dayaftereh/open-knx-valve-control/docs/KNX094_M1_R_10S_LIVE_20261020.md

# KNX094 – Live-Test M1, 10 Sekunden Rueckwaertsfahrt

Stand: 20.10.2026, LLO Desktop Agent v0.8.2.
Board: OpenKNXValveControl V1.2.

## Ergebnis

Der Nutzer beauftragte einen einzelnen 10-Sekunden-Langzeittest
mit Stromueberwachung, um eine vermutete Hard-Endlage des Ventilmotors
im Pruefstand zu beobachten. Gewaehlt wurde die vorher getestete
Richtung R. **Der Impuls lief bis zum 10-Sekunden-Zeitlimit.
Kein Stromanstieg einer mechanischen Blockierung wurde erkannt.**

Aufbau laut Nutzer: USB-C RP2040, Motor M1, sonst keine KNX-,
UPDI- oder Temperatursensorverbindungen. USB Live-ID: COM7,
VID:PID 2E8A:000A, Seriennummer E464401787522D33.
INA219 0x40, Konfiguration 0x399F. R29 0,200 Ohm/1 W.
R33/R34 wurden zuvor auf jeweils 10 Ohm repariert;
INA219-Leerlauf auf plausiblen ca. 0-1mA.

## KNX094 Firmware (aktuell auf dem Board)

Eine separate reproduzierbare Ableitung der zuletzt verifizierten
KNX093-Testfirmware. Die neue Firmware wurde per PlatformIO Core
6.1.16 erfolgreich gebaut: RAM 23,1%, Flash 5,2%.
UF2 **243712 Byte**, SHA256
**c59596c3e3ba27fdd30adc094219953d47a7c59185ce2f55e00b1d04a2d5e284**.

- Es wird nur M1 Rueckwaerts, exakt 10000 ms, angenommen.
  Andere Kanaele, Richtungen und Zeiten werden abgewiesen.
- Keine Motorbewegung beim Boot, KNX TX stets LOW.
- Der Motor braucht ein 5-Sekunden-USB-ARM-Freigabefenster.
- Hardwarezeitgrenze in Firmware: 10000 ms.
- INA219: ca. alle 8 ms beim Motorlauf, bis 1500 Rohtracepunkte.
- Abbruch bei I2C-Fehler, Versorgung ausser 3,10–3,45 V,
  Laufstrom ueber 120 mA oder USB-Verlust.
- Zusaetzlicher Blockierverdacht: erst ab t=400ms, bei
  mindestens 60 mA in 6 direkt aufeinanderfolgenden validen
  INA-Proben wird ein verriegelter FAULT ausgeloest.
  Das ist eine **Software-Strompruefung, keine
  unabhaengige Hardware-Sicherheitsabschaltung**.
- Live-Strommeldungen ca. alle 200 ms.
- Nach Motorende redundanter STOP, STATUS, INA und TRACE.
- Einmalige Flash-/Motor-Marker in Runtime verhindern
  automatische erneute Ausloesung.

Firmwarequelle und Generator:
tools/knx094_motor_10s/src/main.cpp
tools/knx094_motor_10s/src/motor_gate.hpp
tools/knx094_motor_10s/platformio.ini
tools/knx094_motor_10s/generate_from_knx093.py
Host:
tools/knx094_motor_10s/knx094_host.py
tools/knx094_motor_10s/generate_host.py
Offline-Regression: tools/test_knx094_motor_10s.py,
**6/6 PASS**; Python Syntax PASS.

## Flash-Vorgang

Preflight verifizierte COM7, exakte Board-Seriennummer,
Motoren LOW und INA219 Ruhewerte 0..1mA, Bus 3,288–3,292V.
RP2040 per USB CDC1200 in ROM versetzt, Boot-ROM-Flash-ID
E464401787522D33 verifiziert; gepinntes UF2 einmalig
ueber picotool mit Verify und Start geflasht.

Besonderheit: Im KNX094-Build war der alte passive
Diagnosebefehl KNX093 zur Versionsabfrage noch erhalten;
er antwortet aber mit der eindeutigen KNX094-Signatur.
Der erste automatische Post-Flash-Check hatte wegen der
Anfrage KNX094 statt KNX093 abgebrochen. Ein direkter,
rein lesender USB-Check bestaetigte neue KNX094-Firmware,
IDLE und alle GPIOs LOW. Der Host wurde korrigiert und
vollstaendig verifiziert. **Kein zweiter Flash**.

Firmware-Version ueber Diagnosebefehl KNX093:
KNX094 M1_R_ONLY duration_ms=10000 motor_gate=1
limit_ma=120 stall_ma=60 after_ms=400 consecutive=6 latched=0

## Echte einmalige 10s-Fahrt

USB-Befehl: ARM MOTORS, danach PULSE M1 R 10000.
PULSE_STARTED und MOTOR_ENDED state=IDLE bestaetigt.
50 LIVE-Meldungen (200..10000ms), 1250/1250 gueltige
INA219-Rohsamples mit 8-ms-Abstand, t=7..9999ms.

| Kennzahl | Live-Ergebnis |
| --- | ---: |
| Angeforderter Zeitraum | 10000 ms |
| Gueltige INA219-Rohwerte | 1250/1250 |
| Zeitfenster | 7 bis 9999 ms |
| Max. erfasster Anlaufstrom (t=7 ms) | 112,05 mA |
| Min. Strom | 22,85 mA |
| Median gesamt | 28,0 mA |
| Median ab t=400ms | 27,825 mA |
| Maximalwert ab t=400ms | 34,5 mA |
| Strom bei t=9999ms | 31,55 mA |
| Motorversorgung M_VCC | 3260–3288 mV |
| Werte >=60mA nach t400ms | 0 |
| Strom-/Blockier-FAULT | Nein |
| Firmware-Endzustand | IDLE |
| STOP ACK und Ausgangspins LOW | Ja |
| Leerlaufstrom nach STOP | nominal 0 mA |

Der hohe Anlaufwert faellt in den ersten Millisekunden
ab. Ab etwa 400ms bleibt der Strom praktisch konstant
zwischen 23 und 35mA, auch bis zum Ende der 10 Sekunden.
**Ein Hard-End-Anschlag wurde elektrisch NICHT beobachtet.**

Das bedeutet NICHT, dass die Welle nachweislich stillstand:
Moeglich sind ein weiter frei laufender Antrieb, ein
groesserer Weg als 10s oder eine fehlende Getriebe-/
Ventilkopplung. Ob der Nutzer den Motor gehoert/gesehen hat,
wurde noch nicht bestaetigt. Ein kurzer Einschaltpeak
vor dem ersten Messpunkt t7ms wurde nicht erfasst.

## Echtmessdaten und Folgeschritte

Nur auf LLO Desktop unter:
C:\ASH\Workspace\Runtime\KNX094

Dateien:
- KNX094_FLASH_20261020_092752.json
- KNX094_M1_R10000_20261020_093009.json
- KNX094_M1_R10000_20261020_093009.csv
- KNX094_FLASH_STARTED.flag
- KNX094_M1_R10000_STARTED.flag

Die beiden Marker und Messdateien nicht entfernen, um
automatisch noch einmal zu fahren. Kein zweiter Motorpuls
wurde ausgefuehrt. M1 bleibt ausgeschaltet.

Naechster Schritt: Nutzer fragen, ob M1 bei 10 Sekunden
tatsaechlich drehte bzw. mechanische Bewegung/Anschlag
sichtbar oder hoerbar war. Ohne Endstop-Signatur vor
weiteren Laufzeiterhoehungen Kupplung, Getriebe,
Ventilweg und Verschaltung pruefen. Kein Git Push
ohne separate Freigabe.
