dayaftereh/open-knx-valve-control/docs/KNX090_INA219_CLEANED_R33_R34_MPN_20K_20261019.md

# KNX090 – INA219 nach Reinigung; 20 kOhm Sense-Pfad

Stand: 19.10.2026, ca. 22:18 MESZ, LLO Home Agent v0.7.9.

## Benutzer-Messungen nach Platinenreinigung

- Dreck/Flussmittel-/Lotrueckstaende zwischen U23/INA-Pads wurden entfernt.
- Spannung an den U23-seitigen Sense-Pads von R33 Pad2 (IN+) nach
  R34 Pad2 (IN-): ca. **+82 mV** laut Nutzer.
- Ohmischer Messwert zwischen R33 Pad2 und R34 Pad2 laut Nutzer:
  ca. **20 kOhm**.
- Zuvor direkt an R29 (200 mOhm/1 W) ca. **0.00 mV DC** laut Nutzer.
- Bei der Ohm-Messung wurde der Versorgungszustand nicht
  mitgeteilt. Ohm-Werte sind nur bei VOLLER Spannungsfreiheit
  interpretierbar. USB, KNX und UPDI koennen mehrere
  Versorgungsquellen darstellen.

## Live-RP2040 nach der Reinigung

Keine Motorbewegung, kein Reset/Flash, nur KNX089 INA_REGS:
- RP2040 COM8, bekanntes USB-Gerät.
- CONFIG 0x00 = **0x399F**.
- SHUNT 0x01 = **9259 LSB = 92.59 mV**.
- VBUS 0x02 = **3148 mV**.
- CAL 0x05 = **0** (erwartbar; Roh-Shunt ohne CAL nutzbar).
- Motorausgaenge KNX089 firmwareseitig LOCKED, gate0, GPIO LOW.

Beleg:
C:\_myspace\workspace\Builds\OpenKNXValveControl\KNX089_R29_0MV\KNX089_REGISTER_DIAG_20261019_221814.json

Der Wert hat sich durch die Reinigung (zuvor ~92.6mV) nicht
erkennbar geaendert. User-DMM 82mV und INA 92.59mV sind in derselben
Groessenordnung, aber keinesfalls gleich und kein Beweis
einer korrekt angeschlossenen Sensoreingangsstrecke.

## Unerwarteter EDA/MPN-Widerspruch bei R33/R34

Quellstand: schematic/pcb_knx-valve-control_v1.2.json

| Teil | Symbolischer WERT | Pad1 PCB | Pad2 PCB | MPN/LCSC |
|---|---|---|---|---|
| R33 | 10 Ohm | 3.3V | U23_8, INA219 IN+ | 0402WGF1002TCE / C25744 |
| R34 | 10 Ohm | M_VCC | U23_7, INA219 IN- | 0402WGF1002TCE / C25744 |
| R29 | 0.200 Ohm,1W user confirmed | 3.3V | M_VCC | PCB MPN not trustworthy |

Hersteller-/Lieferanten-Katalog fuer **C25744 / 0402WGF1002TCE**:
UNI-ROYAL **10kOhm ±1%**, Gehaeuse **0402**.
Beleg: https://www.lcsc.com/de/product-detail/C25744.html

Ein tatsaechlich eingebautes Widerstandspaar R33+R34
mit 10kOhm ergibt zusammen ueber R29 ca.
**10,000 + 0.200 + 10,000 = 20,000.2 Ohm**.
Dies stimmt bemerkenswert gut mit den 20kOhm des Nutzers ueberein.
Bei den im Schaltplansoll enthaltenen 10Ohm je Widerstand
waeren nur ca. **20.2 Ohm** zu erwarten, solange die
Sense-Leitungen zwischen R33/R34 und R29 durchgaengig sind.

**WICHTIG**: Das EasyEDA-Projekt benutzt dieselbe 10kOhm
Bauteilnummer nicht nur bei R33/R34, sondern bei 37
Widerstands-Footprints mit voellig verschiedenen
Design-Werten. Ebenso ist die MPN CC0603KRX7R9BB103
(10nF, C100042) bei 24 Kondensatoren mit gemischten
Design-Werten hinterlegt, darunter C31 (100nF SOLL).
Die MPNs sind daher anscheinend pauschale Bibliotheks-
Metadaten und **KEIN verlaesslicher Bestueckungsnachweis**.
Ob R33 und R34 real 10kOhm enthalten, beweist nur eine
geeignete individuelle stromlose Widerstandsmessung bzw.
Bestueckungsnachweis.

Starkes Verdachtsmoment: R33/R34 physisch als 10kOhm statt
10Ohm bestueckt (oder ein offener Sense-Pfad). Solche
hochohmigen Sense-Zuleitungen koennen zusammen mit INA219-
Eingangsbias/Leckstroemen und Flussmittelresten falsche
Differenzwerte im ADC verursachen. Das rein digitale I2C-
Register-Reading bleibt dabei fehlerfrei.

## Naechster Test vor weiterer INA219-Firmwarearbeit

Bei **komplett stromloser Platine** (USB, KNX-TP-Stecker,
UPDI ab, Puffer entladen) R33 und R34 **einzeln
zwischen jeweils Pad1 und Pad2** im Ohm-Modus messen.

- R33 etwa 10kOhm und R34 etwa 10kOhm:
  Widerstands-Bestueckung ist sehr wahrscheinlich FALSCH;
  je 10Ohm 0402 einsetzen und Sense-Differenz unter
  sicherer Versorgung neu pruefen.
- Beide je ~10Ohm:
  dann Unterbrechung von den Serien-R zu R29
  oder echte Leiterbahn-/Kontaktprobleme genauer pruefen.
- Nur einer ~10kOhm / offen:
  genau diese Verbindung bzw. Bestueckung lokalisieren.

Keine Ohm-Messung bei angeschlossener Spannung.
Falls Messwerte in-circuit uneindeutig, ein Anschluss
stromlos entloeten oder mit Originalbestueckungsunterlagen
vergleichen; nicht aus bloßer MPN schließen.

Motoren und KNX TX bleiben bei aktueller KNX089-Firmware
gesperrt. Kein neuer Flash, keine Motorfahrt, kein Git Push.

Empfehlung fuer kommende PCB-Version: BOM/MPN fuer R33,
R34 und weitere Bauteile konsistent mit Designwerten
ueberarbeiten; pauschale Platzhalter entfernen.
