dayaftereh/open-knx-valve-control/docs/KNX086_R17_LIVE_FLASH_INA219_20261019.md

# NACHFOLGENDER KNX087-BESTUECKUNGSNACHTRAG / 19.10.2026

Der Nutzer hat R29 als tatsaechlich bestueckten **200-mOhm-/1-W-Shunt** bestaetigt. Die fruehere Ungewissheit ueber die R29-Bestueckung und die Aufforderung, diesen Sollwert nochmals durch die BOM zu bestaetigen, ist damit ueberholt. Der Code rechnet bereits mit 200 mOhm, sodass keine Neukonfiguration/kein Firmwareflash erforderlich ist. Die gemessenen ~463 mA im Stillstand bei ausgeloeschten Motorausgaengen bleiben jedoch eine ungeklare M_VCC-Ruhebelastung bzw. INA219-Messpfadfrage. Aktuelle Einordnung: [KNX087-R29-Bestueckung](KNX087_R29_200MOHM_1W_CONFIRMED_20261019.md).

---

# KNX086 – Korrektur R17-Flashbewertung, Live-Flash und INA219-Befund

Datum: 19.10.2026, LLO Home Agent 0.7.9, Session
ses-20261019T060953-3532fd2b09cb.

## Korrektur gegenüber bisherigen KNX085-Aussagen

Der Nutzer hat mehrfach ausdrücklich darauf hingewiesen, dass das
frühere U11-Überhitzen mit der **fehlerhaften R17-KNX_TX-Pull-up-
Bestückung** zusammenhing und dass Reset/BOOTSEL mit dem PicoScope
untersucht wurden. Frühere Antworten setzten U11-Überhitzung fälschlich
direkt mit Firmware-Flashen gleich und erklärten Flash mit KNX/UPDI
pauschal für unmöglich. Diese pauschale Aussage ist WIDERLEGT durch
die dokumentierte Betriebshistorie.

Originale Evidenz aus dem Repository:
- KNX035: R17 Pull-up 10 kOhm von KNX_TX nach 3,3 V; aktives HIGH
  von STKNX verursacht physikalische KNX-Sendestromimpulse über U11.
- KNX043: nach R17-Entfernung kein PicoScope-Trigger oberhalb
  0,35 V während des beobachteten RUN-Resets (nicht jede Brownoutform
  geprüft).
- KNX076: mit angeschlossenem KNX-Testbus via BOOTSEL Firmware
  erfolgreich geflasht. KNX_TX in BOOTSEL ca. 0,086 V median,
  nach Flash 0,086 V median, max. 0,173 V in damaligem Messfenster.
- KNX081: RP2040 über 1200-Baud in BOOTSEL gesetzt, mit KNX-TP
  auf Linie 1.3 ein offizielles Telegramm von IA 1.3.250 gesendet
  und auf dem KNX/IP-Interface empfangen. KNX_TX sonst LOW.
- KNX084: **bereits am 18.10. mit KNX-TP 1.3, CH340/UPDI CN1,
  Motoren M1/M2 und vier DS18B20 angeschlossen erfolgreich geflasht**.
  Temperatur-RX und passive KNX-RX anschließend PASS.

Die thermische Schadensursache ist nach Schaltung und Nutzerangabe der
R17-Pull-up-Fehler, nicht der USB-Flashvorgang. Der konkrete physikalische
U11-Heizstrom vor dem Umbau wurde historisch nicht gleichzeitig
gemessen; die Fehlerhypothese bleibt technisch sehr plausibel, aber
nicht als unabhängig nachgemessene Kausalität formulieren.

Konsequenz: Auf dem bereits erfolgreich geprüften TESTAUFBAU sind
KNX- und UPDI-Anwesenheit KEINE automatischen Flash-Blocker. Neue
Firmware muss weiterhin vor dem Flash KNX_TX LOW vorsehen, die
RP2040-USB-Identität exakt prüfen, den UF2-Hash kontrollieren und
beim Auftreten neuer Fehler fail-closed bleiben.

Historische Berichte dürfen die vorherige Fehlbestückung und
Messgrenzen dokumentieren; die jetzige Testführung darf die alten
pauschalen Flash-Sperren nicht weiter als unveränderliche Wahrheit
interpretieren.

## KNX086 tatsächlich durchgeführter Flash auf LLO Home

Vorprüfung:
- LLO Home Agent erreichbar, keine fremde aktive Write-Session.
- Git main vor der Arbeit 3d039f2, clean, ahead origin/main 4.
- RP2040 COM8, 2E8A:000A, Seriennr. E464401787522D33.
- CH340/UPDI COM5, 1A86:7523, angeschlossen.
- Aktuelles KNX084 TX LOW, alle Motorenable/Richtung LOW.
- T0=14,63 °C, T1=14,44 °C, T2=14,19 °C, T3=14,19 °C VALID.
- KNX-RX seit KNX084-Start ca. 2,15 Mio. Flanken.
- Vorliegendes KNX085 bench_unlocked UF2 242688 Byte,
  SHA256 86CBF6942FD12EBA07402C52842BA7543CABD2C2A557A329607C954388A54750.
  Verbietet unbeabsichtigte KNX-TX-Befehle, schaltet GPIO0 LOW,
  erlaubt ausschließlich explizite M1/M2-USB-Arming-Pulse <=250 ms.

Live-Aktion:
1. Offizieller Arduino-Pico-1200-Baud CDC-Bootloaderwechsel einmal
   angestoßen. Windows meldete im USB-Verschwinden die bereits aus
   KNX050 bekannte COM-Konfigurationsausnahme; kein zweiter Reset.
2. Verifiziertes RP2040-ROM-Laufwerk RPI-RP2 / Board-ID RPI-RP2.
3. Exact SHA-verifiziertes KNX085 UF2 genau einmal via UF2-Laufwerk
   kopiert, kein wiederholtes Upload.
4. Controller erschien mit korrekter USB-ID wieder auf COM8.
5. KNX085 real bestätigt: STATUS tx_low=1, motors_low=1,
   uart_ready=1, motor_gate=1, motor_state=IDLE.
6. Vier DS18B20 gültig, passive KNX_RX-Kanten steigen weiter.
7. Keine physische KNX-Sendeaktion, kein UPDI-Schreibzugriff,
   noch keine motorische Bewegung.

Die tatsächliche KNX085-Firmware ist JETZT auf dem realen RP2040.

Maschinenlesbare private Evidenz (nicht als Repo-Dateien):
- C:\_myspace\workspace\Builds\OpenKNXValveControl\KNX086_LIVE_M1\KNX086_BEFORE_FLASH_20261019_081700.json
- C:\_myspace\workspace\Builds\OpenKNXValveControl\KNX086_LIVE_M1\KNX086_FLASH_20261019_081703.json

## INA219-Hardware nach Flash

Reale INA219-Kurzabfrage:
- I2C-Adresse 0x40 reagiert, Konfiguration 0x399F, valid read.
- Motorversorgung M_VCC gemeldet ca. 3.148 V.
- Shunt-Rohsignal entspricht rund +92.6 mV, wenn INA219
  korrekt 10 µV pro Roh-Count ausgibt.
- Bei **nur angenommener** R29=0,200 Ohm entspricht dies
  scheinbar ~463 mA, obwohl M1/M2 GPIO ausdrücklich LOW sind.

Unabhängige 24-Sample-Leerlaufserie ohne Motorbefehl:
- Motoren: ALLE AUS, KNX_TX LOW.
- INA219 Bus min 3144 mV, max 3152 mV.
- Nominalstrom min 462 mA, Median 463 mA, max 463 mA.
- Roh-Shunt-Delta aus dieser Annahme ~92.6 mV.
- Messreihe gespeichert unter
  C:\_myspace\workspace\Builds\OpenKNXValveControl\KNX086_LIVE_M1\INA_IDLE_20261019_082147.json

Dies ist KEIN nachgewiesener echter Motorstrom. Der PCB-V1.2-
Schaltplan bezeichnet R29 als 0,200 Ohm / 1 W; die PCB
Hersteller-Teilenummer SCR1206F1M1 / C3017245 ist seit KNX022/033
als widersprüchlich dokumentiert; auf dem realen Foto war nur der
R29-Footprint sichtbar, nicht der tatsächliche Widerstandswert.

Ohne verifizierten realen R29-Wert kann aus der Shuntspannung KEINE
verlässliche mA-Aussage abgeleitet werden. Der ~463-mA-Wert bei
abgeschaltetem Motor weist auf einen R29/BOM-/Verdrahtungs- bzw.
Messpfadkonflikt hin. Nicht als normalen Antrieb-Leerlaufstrom
interpretieren.

## Ergebnis M1

Der Benutzer hat M1-Test ausdrücklich freigegeben. Der neue Host
tools/knx085_motor_diag/knx086_live_connected.py bietet eine
Live-Variante mit angeschlossenem KNX und UPDI; frühere unnötige
physische Absteck-Sperren sind dort entfernt. Die IDENTITÄTS-,
INA219- und Strom-/Spannungs-Schutzbedingungen bleiben erhalten.

Aufruf von M1 F / 150 ms wurde durchgeführt, aber die Firmware/
Host-Logik hat den Start vor ARM/PULSE wegen des hohen ungeklärten
INA219-Leerlaufwerts abgelehnt:
'INA219 address/calibration/config/supply or idle gate FAILED; no motor'.

- **M1 hat nicht bewegt**.
- Kein Homing/Anschlag, kein erfasster M1-Lauf- oder Blockstrom.
- Motor-Ausgänge weiterhin LOW, keine KNX TX-Daten gesendet.
- Die neue Firmware bleibt für weitere Diagnosen installiert.

## Nächste nachvollziehbare Schritte

1. Den tatsächlich auf R29 bestückten Bauteilwert durch BOM,
   lesbare Bauteilaufschrift oder stromlose Vierleitermessung
   klären; Schaltplansoll 0,200 Ohm, nicht MPN-Metadaten glauben.
2. Versorgung 3.3 V und M_VCC, differenzielle Shuntspannung,
   Eingangspolarität und mögliche alternative Versorgungspfade
   elektrisch gegenüberstellen.
3. Erst dann INA219-Kalibrierung und Plausibilitätsfenster an
   realer Platine anpassen; die bestehende 120-mA-Ratinggrenze
   nicht als willkürliche Endstopschwelle übernehmen.
4. Wenn Idle sauber ist, einzelnen M1 Kurzimpuls (50–150 ms)
   mit realer differenzieller Stromspur freigeben und beobachten.
5. Später Homing-/Blockierungsschwelle aus laufenden Testdaten
   ableiten, mit mehrfachem Sampling und sofortiger Abschaltung.

Keine Reflash-/Motor-Wiederholung, kein Git-Push ohne gesonderten
Auftrag. U11 historisch als behobenes R17-Pullup-Ereignis
einordnen; nicht wieder als pauschale Flash-Verweigerung verwenden.
