dayaftereh/open-knx-valve-control/docs/KNX084_PASSIVE_BUS_ATTINY_T0_T3_LIVE_20261018.md

# KNX084 - Passive KNX TP1 reception and live T0-T3 temperature diagnostic

**2026-10-18, LLO Home: BUILD / FLASH / LIVE TEMPERATURES / KNX RX PASS.**
No KNX TP transmit, motor movement, UPDI flash or ETS download.

## Task and real equipment

User reconnected KNX TP cellar line 1.3, RP2040 USB-C in BOOTSEL,
Units V1.2 / CH340 UPDI programmer via CN1, four DS18B20 temperature
sensors T0/T1/T2/T3, and real test-valve motors at M1 and M2.
PicoScope channels A/B were removed. User saw both 3.3V and 5V LEDs lit.
Exact voltage rails, backfeed and motor current were NOT DMM measured.

Live LLO Home enumerated:
- RP2040 in ROM RPI-RP2 BOOTSEL, VID:PID 2E8A:0003, UF2 FAT D:,
  INFO_UF2.TXT Board-ID RPI-RP2, later firmware CDC COM8 2E8A:000A.
  Optional RP2 Boot MI_01 Windows driver was missing (Code28);
  UF2 mass storage is working without picotool WinUSB.
- CH340 Programmer, VID:PID 1A86:7523, COM5 driver OK.
- Read-only UPDI pymcuprog ping of ATtiny3216 via COM5:
  signature **1E 95 21**, exit0 (no erase/fuse/write).
- Passive MDT KNX/IP TUNNELING reachable and receiving third-party
  telegrams; does not prove the newly connected prototype electrical
  KNX bus without actual RX evidence below.
- Git initial HEAD d128d39 clean and synced origin/main.

## Firmware isolation and fixed GPIO safety contract

Built isolated RP2040 image in tools/knx084_passive_rx_temp/
with src/main.cpp and platformio.ini.

- **GPIO0 -> STKNX U9 KNX_TX**: SIO output preloaded **LOW**, never set HIGH,
  repeated LOW reassertion about every 100ms. NO PIO KNX transmit
  program, no Serial1/UART0, no TPUart/GroupValueWrite, no output API.
- **GPIO1 <- STKNX U9 KNX_RX**: INPUT, CHANGE interrupt, raw timestamped
  rising/falling RX edge recorder with 4096-slot ring buffer.
  Every interval USB emits passive RXSTATS; permitted RXDUMP exports
  captured bus edges but never drives TP.
- **GPIO10..17 motor enables**, **GPIO18/19 common directions**:
  ALL SIO outputs set LOW in setup before serial initialization, and
  reassert LOW regularly. No motor drive/PWM/direction commands.
  All USB commands except STATUS, TEMPS, RXSTATS, RXDUMP, HELP refused.
- **GPIO8 TX / GPIO9 RX** use UART1/Serial2 at 115200 Baud to ATtiny3216
  U25 PA2 RX / PA1 TX. Every ~2.1s request a CRC-protected cached snapshot
  (8-byte request, 67-byte response, protocol KNX014).
  Parser enforces CRC16, sequence, response type and nine-channel
  flags/faults; return only T0..T3 with invalid data as temp_c=NA.
  Arduino-Pico SerialUART::availableForWrite() is Boolean and guarded
  with <=0, as proven in KNX041.

The firmware controls GPIO only **after application startup**. It
CANNOT guarantee electrical TX or motor LOW during power-on, BOOTSEL,
reset or brownout. The V1.2 TB6612 STBY pin is hardwired HIGH; there is
no independent motor STO. This is NOT certified hardware safety.

PlatformIO (pinned Arduino-Pico 5.5.0) build SUCCESS, UF2 **158208B**,
SHA-256:

    E3C484719AC7F4F6F00AB24A30A45B4FDB677E0899C9042482AE2A925466891D

Verified the target RPI-RP2 D: Board-ID, USB VID/PID, image size
and SHA. Copied the UF2 **exactly once** in the authorized BOOTSEL
deployment. The RP2040 left BOOTSEL and re-enumerated as COM8.

## First live USB inspection - PASS

Read-only USB STATUS, TEMPS, RXSTATS immediately after flash:

    KNX084 STATUS tx_low=1 motors_low=1 uart_ready=1 snapshots=5
    timeout=0 rejected=0 rx_edges=316 NO_KNX_TX_NO_MOTOR_ACTUATION

Real accepted ATtiny snapshot:
- T0: **15.25 C**, flags=3, fault=0, age0
- T1: **15.00 C**, flags=7/3, fault=0
- T2: **14.81 C**, flags=7/3, fault=0
- T3: **14.81 C**, flags=3, fault=0

KNX_RX recorded **316 transitions** (158 rising, 158 falling),
zero edge loss at this first check. Values are NOT generated by the
RP2040 from fabricated input: received from the real ATtiny over the
real UART, validated by the shared temperature frame parser.

## Long observations and actual bus telegrams

Private first raw COM8 recording (75s):
- KNX084_LIVE_20261018_232057.txt
- KNX084_LIVE_20261018_232057_summary.json
- KNX084_RX_OFFLINE_20261018_232057.json

It captured **41 complete accepted T0..T3 snapshots**, all
**41/41 valid in EACH of the four channels**. The independently
recorded firmware status showed zero timeouts/rejected responses,
and KNX_TX + motors continually LOW.

Raw STKNX KNX_RX edges from the capture were processed OFFLINE by
tools/knx084_passive_rx_temp/knx084_decode_capture.py using the
existing KNX070 TP1 parity/checksum/ACK decoder:
**4095 edges, 2047 physical active pulses, 27 frame groups;
25 passed framing, parity and checksum.**
Examples include real GroupValueWrite telegrams from
1.3.40 -> 4/2/5 and 1.3.43 -> 4/2/0 / 4/2/1,
with ACK 0xCC. This verifies simultaneous passive KNX TP1 RX
and active UART1 temperature communication without any TP transmit.

One defect was found in the HOST monitor schedule, not in
temperature data: the initial RXDUMP occurred too late, allowing
the 4096-slot ring to fill. An initial total of **1897 older edges**
were dropped while RXSTATS still counted all **6612** physical
edges. The serial RXDUMP itself is passive. This was corrected to
drain at connect and then every **8s**.

Second USB observation (43s):
- KNX084_LIVE_20261018_232335.txt
- KNX084_LIVE_20261018_232335_summary.json
- KNX084_RX_OFFLINE_20261018_232335.json

**24/24** additional T0..T3 sensor snapshots valid, 0 timeout,
0 rejected; 13/13 recorded status rows tx_low=1,
motors_low=1, uart_ready=1. Last displayed values:
T0=15.25C, T1=14.88C, T2=14.75C, T3=14.81C.

The pre-existing RX ring was already full at the second monitor start.
While awaiting the first scheduled 4s drain, the cumulative lost count
increased from 4110 to **4578**. **After the first drain it stayed
constant** through the remaining measurements. The monitored
timestamp stream contained **5375 RX edges, 2687 physical
35us pulses, 35 decoder groups; 34/35 passed full
parity/start-stop/checksum/ACK checks**, including messages from
Keller devices 1.3.40, 1.3.41, 1.3.43 and 1.3.44.
The monitor was finally improved to drain immediately on connection
instead of at 4s; that last scheduling edit does not affect the
already-flashed RP2040 firmware.

**Overall during 118s of serial measurements:** 65 accepted sensor
snapshots; T0/T1/T2/T3 each valid in all 65, temperature ranges around
14.75-15.31C. There was no software-requested KNX transmission or
motor command at any stage.

## Verification and next slice

New source safety tests cover GPIO0 never HIGH, every motor pin LOW,
setup order, exact command whitelist, UART CRC/sequence, T0-T3
validation, RX ring, and disabled auto-upload. Additional tests cover
immediate periodic USB RX draining and synthetic TP1 frame/ACK
decode. Combined KNX070..KNX084 suite: **52/52 PASSED**.
Full source, platformio.ini, read-only USB monitor and offline decoder
are committed in the project; raw port log is private in Downloads.

**Next suggested KNX085**: preserve this KNX_RX+temperature baseline,
review M_VCC, actual motor type/rating/current, INA219/R29, driver
GPIO default/reset STBY interlock and STOP. Only then implement
a bounded, separately authorized short M1 test followed by M2,
one at a time, without sending unsolicited KNX telegrams.

Outstanding electrical gates: U11 heating history, D1 bridge,
F1 rating, STKNX VCCCORE under bus power, CN1 UPDI-pin1 5V/backfeed
with KNX+USB+CH340, physical voltage/current measurements and
GPIO0 reset/BOOTSEL fail-low qualification. LEDs lit and software
GPIO reads are not a substitute for DMM measurements.

No ETS modifications and no Git push requested during KNX084.

## Final non-actuating runtime check (after long unattended operation)

A later independent read-only COM8 STATUS / TEMPS / RXSTATS check
confirmed the same firmware running continuously with:

    KNX084 STATUS tx_low=1 motors_low=1 uart_ready=1
    snapshots=223 timeout=0 rejected=0 rx_edges=31680

At that time T0=15.19C, T1=14.88C, T2=14.75C,
T3=14.69C; flags=3 and fault=0 on every channel, with
ages 2-3s. GPIO0 and all ten motor output pins still read LOW.
RX counts were 15,840 rising and 15,840 falling.
The 4096-event timestamp ring was full (buffered=4095)
and accumulated 18,115 discarded OLD event timestamps during
unattended observation, as expected from its finite design.
This is a limitation of long-term waveform archival without the
live serial monitor, NOT evidence of a KNX bus failure.
The counters continue monitoring even when the ring is full;
the final host tool drains the ring immediately on connection
and every eight seconds afterwards.

To avoid losing complete raw telegram history over hours, run
the monitor continuously or add a bounded rolling-buffer or
external logging improvement in a future slice. No further
firmware reflashing was necessary for this first temperature
and RX verification.
