dayaftereh/open-knx-valve-control/.ash/WORKFLOW.md

# ASH Workflow fuer OpenKNXValveControl

**Protocol:** [ASH Project Workflow v1](../docs/reference/ash/README_PROJECT_WORKFLOW.md)

**Project root:** `C:\ASH\Workspace\Projects\open-knx-valve-control`

**Git:** `main`, origin `https://github.com/dayaftereh/open-knx-valve-control.git`

**Profil:** `software`, erweitert um Elektronik-/EasyEDA-, ETS6- und `research`-Pruefungen. Eine pauschale KiCad-DRC-Bestaetigung waere fuer die hier hinterlegten EasyEDA-JSONs unzutreffend.

## Verbindliches Arbeitsmodell

- **Project**: Repository und permanente Spezifikationen/Artefakte; **Slice**: ein pruefbares, abgeschliessbares Arbeitspaket; **Session**: ersetzbare Agent-/Chat-Arbeitsinstanz.
- Standardmaessig **genau ein aktiver Write-Slice**. Die LLO-Desktop-Session-Sperre ersetzt nicht den offenen repo-sichtbaren Slice-Marker.
- Bei einer neuen Session stets zuerst Root, Agent-/Session-Eigner, laufende Jobs/Checkpoint, `git status --short --branch`, `docs/slices/_OPEN_*.md` und relevante Fachdokumente verifizieren.
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
