dayaftereh/open-knx-valve-control/assets/3d-models/knx-value-control/knx-valve-control-din-rail-mount.FCStd

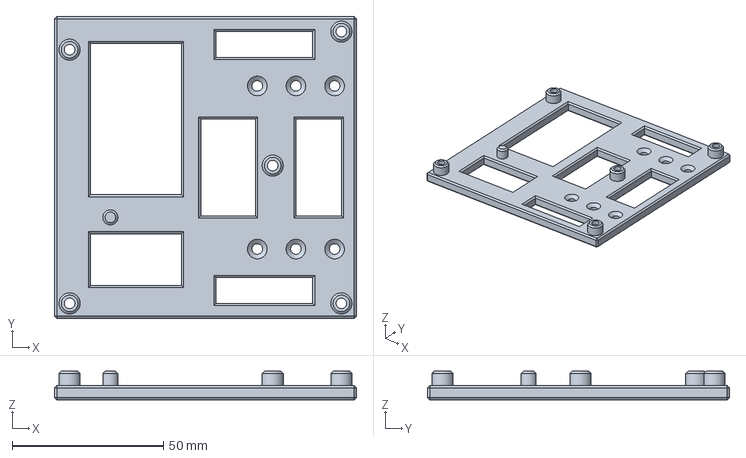
[picture p1: CAD file, 2026-01-21]
assets/3d-models/knx-value-control/knx-valve-control-din-rail-mount.FCStd
100.0 x 100.0 x 9.50 mm
