dayaftereh/open-knx-valve-control/assets/3d-models/usb-broker/usb-broker-lid.stl

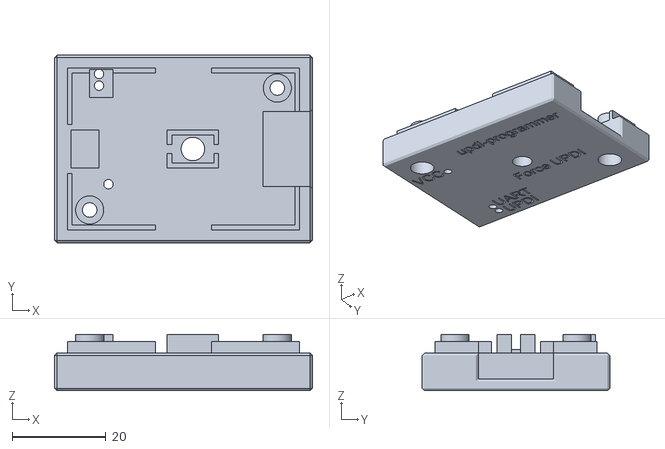
[picture p2: CAD file, 2025-12-12]
assets/3d-models/usb-broker/usb-broker-lid.stl
55.0 x 40.0 x 12.0
