dayaftereh/open-knx-valve-control/assets/3d-models/usb-broker/usb-broker-case.FCStd

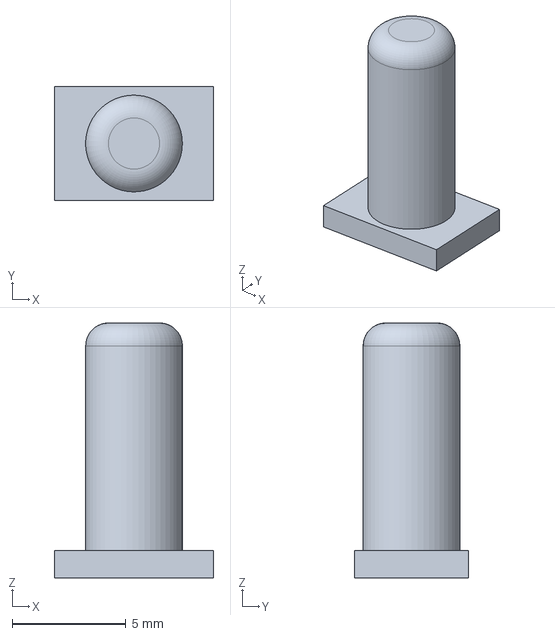
[picture p3: CAD file, 2025-12-12]
assets/3d-models/usb-broker/usb-broker-case.FCStd
7.00 x 5.00 x 11.2 mm
