dayaftereh/open-knx-valve-control/(list of files, cad)

Other CAD files:
assets/3d-models/usb-broker/usb-broker-button.stl
assets/3d-models/knx-value-control/knx-valve-control-din-rail-mount.stl
assets/3d-models/usb-broker/usb-broker-case.stl
