dayaftereh/open-knx-valve-control/schematic/sch_knx-valve-control_v1.2.pdf

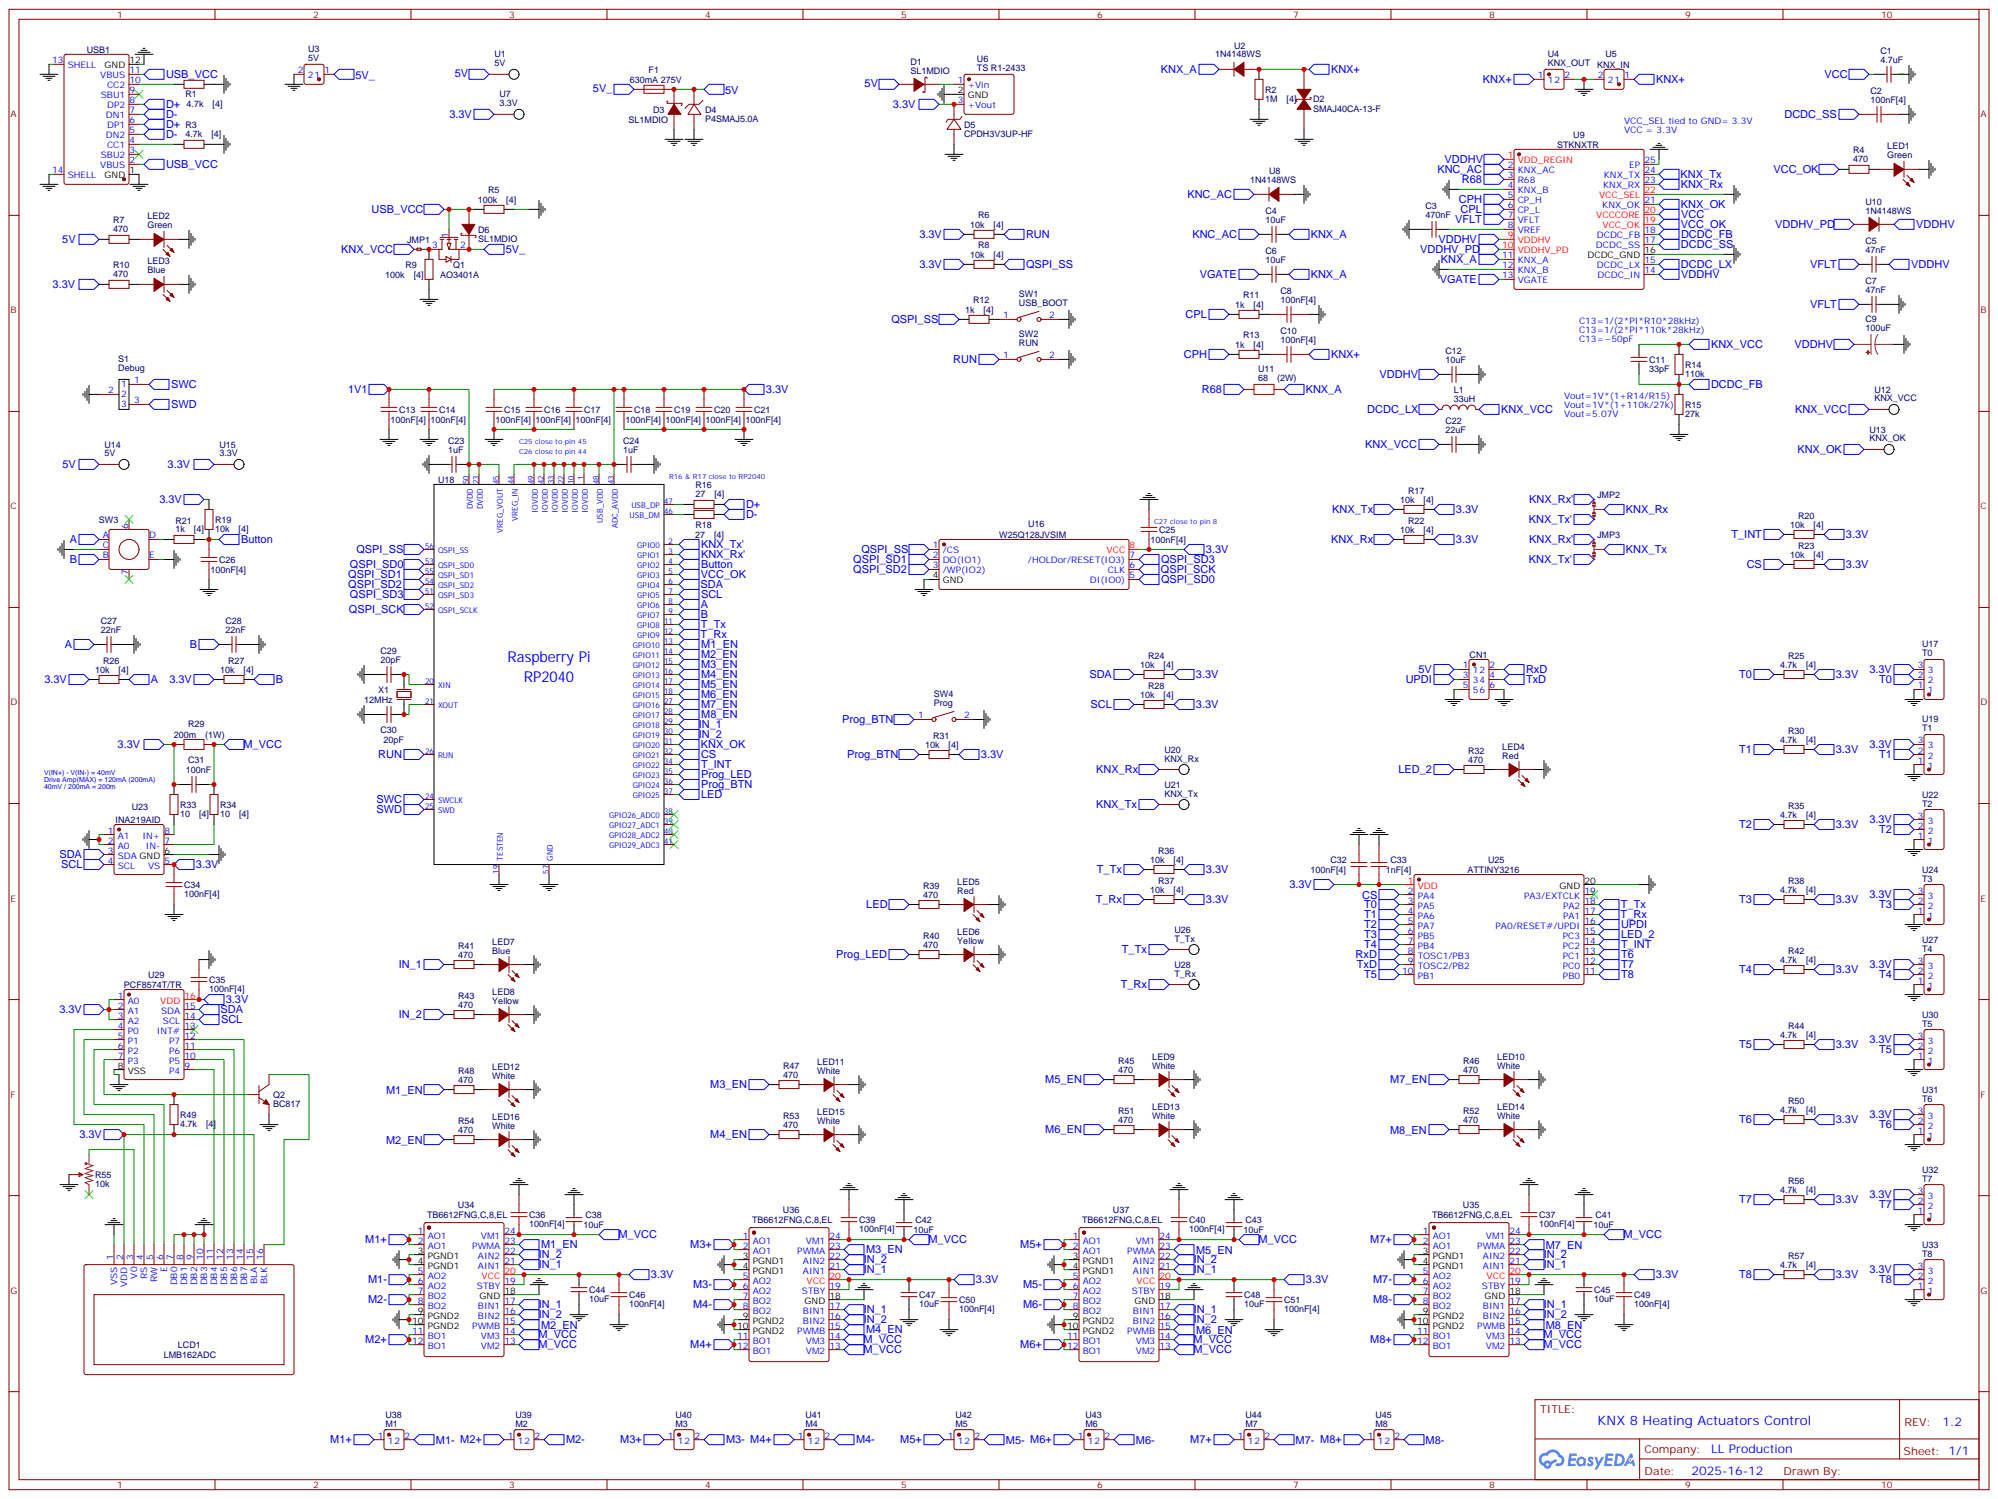
[picture p4: page 1]

P5 10 P6 11 P7 12 INT# 13 SCL 14 SDA 15 VDD 16
