dayaftereh/open-knx-valve-control/schematic/sch_updi_programmer_v1.4.pdf

## USB_D-USB_D+

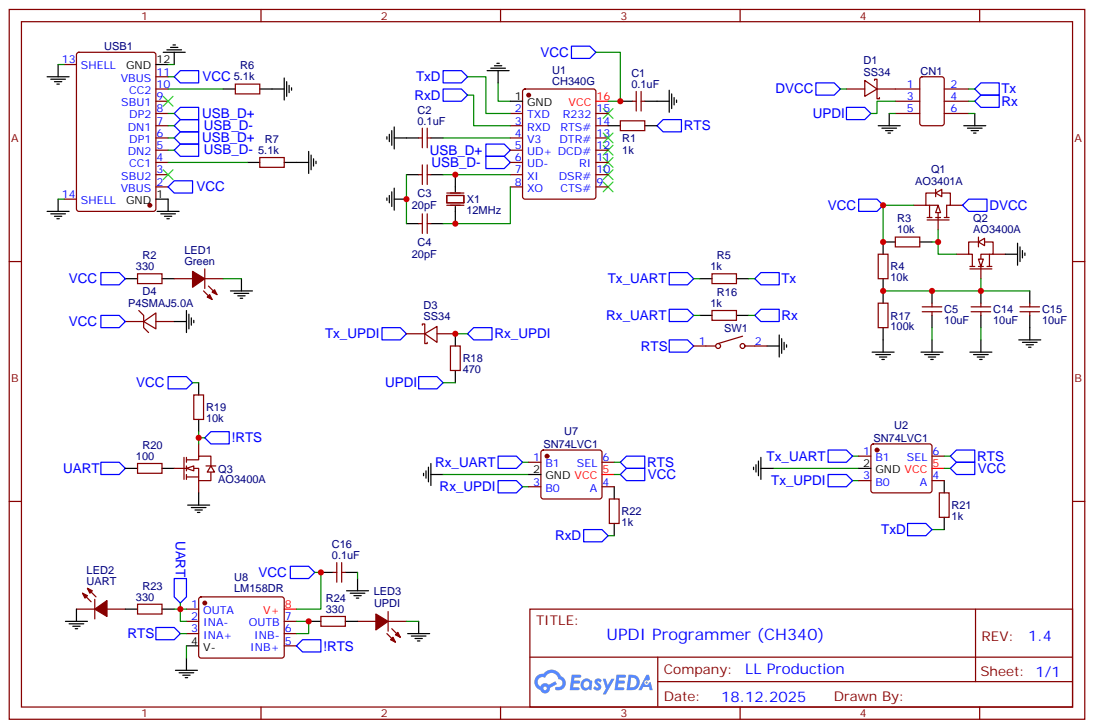
[picture p5: page 1]

DSR# 10 RI 11 DCD# 12 DTR# 13 RTS# 14 R232 15 VCC 16
