dayaftereh/open-knx-valve-control/(list of files, drawings)

Other design files:
schematic/pcb_knx-valve-control_v1.2.json
schematic/pcb_updi_programmer_v1.4.json
schematic/sch_knx-valve-control_v1.2.json
schematic/sch_updi_programmer_v1.4.json
