dayaftereh/open-knx-valve-control/include/knxprod.hpp

#pragma once


#define paramDelay(time) (uint32_t)( \
            (time & 0xC000) == 0xC000 ? (time & 0x3FFF) * 100 : \
            (time & 0xC000) == 0x0000 ? (time & 0x3FFF) * 1000 : \
            (time & 0xC000) == 0x4000 ? (time & 0x3FFF) * 60000 : \
            (time & 0xC000) == 0x8000 ? ((time & 0x3FFF) > 1000 ? 3600000 : \
                                         (time & 0x3FFF) * 3600000 ) : 0 )
                                             
// Parameter with single occurrence
#define StartupDelay                         0      // uint16_t
#define StartupDelaySelection                2      // 16 Bits, Bit 15-0
#define Drive1Active                         4      // 1 Bit, Bit 7
#define     Drive1ActiveMask 0x80
#define     Drive1ActiveShift 7
#define Drive2Active                         4      // 1 Bit, Bit 6
#define     Drive2ActiveMask 0x40
#define     Drive2ActiveShift 6
#define Drive3Active                         4      // 1 Bit, Bit 5
#define     Drive3ActiveMask 0x20
#define     Drive3ActiveShift 5
#define Drive4Active                         4      // 1 Bit, Bit 4
#define     Drive4ActiveMask 0x10
#define     Drive4ActiveShift 4
#define Drive5Active                         4      // 1 Bit, Bit 3
#define     Drive5ActiveMask 0x08
#define     Drive5ActiveShift 3
#define Drive6Active                         4      // 1 Bit, Bit 2
#define     Drive6ActiveMask 0x04
#define     Drive6ActiveShift 2
#define Drive7Active                         4      // 1 Bit, Bit 1
#define     Drive7ActiveMask 0x02
#define     Drive7ActiveShift 1
#define Drive8Active                         4      // 1 Bit, Bit 0
#define     Drive8ActiveMask 0x01
#define     Drive8ActiveShift 0
#define Drive1ControlLoop                    5      // 1 Bit, Bit 7
#define     Drive1ControlLoopMask 0x80
#define     Drive1ControlLoopShift 7
#define Drive2ControlLoop                    5      // 1 Bit, Bit 6
#define     Drive2ControlLoopMask 0x40
#define     Drive2ControlLoopShift 6
#define Drive3ControlLoop                    5      // 1 Bit, Bit 5
#define     Drive3ControlLoopMask 0x20
#define     Drive3ControlLoopShift 5
#define Drive4ControlLoop                    5      // 1 Bit, Bit 4
#define     Drive4ControlLoopMask 0x10
#define     Drive4ControlLoopShift 4
#define Drive5ControlLoop                    5      // 1 Bit, Bit 3
#define     Drive5ControlLoopMask 0x08
#define     Drive5ControlLoopShift 3
#define Drive6ControlLoop                    5      // 1 Bit, Bit 2
#define     Drive6ControlLoopMask 0x04
#define     Drive6ControlLoopShift 2
#define Drive7ControlLoop                    5      // 1 Bit, Bit 1
#define     Drive7ControlLoopMask 0x02
#define     Drive7ControlLoopShift 1
#define Drive8ControlLoop                    5      // 1 Bit, Bit 0
#define     Drive8ControlLoopMask 0x01
#define     Drive8ControlLoopShift 0
#define PrePostTemperaturesOutput            6      // 1 Bit, Bit 7
#define     PrePostTemperaturesOutputMask 0x80
#define     PrePostTemperaturesOutputShift 7
#define TemperatureSendIntervalSeconds       7      // uint16_t
#define TemperatureChangeThresholdCenti      9      // uint16_t

//         Zeit (Sekundengenau)
#define ParamStartupDelay                        (knx.paramWord(StartupDelay))
// Zeit bis das Gerät nach einem Neustart aktiv wird
#define ParamStartupDelaySelection               (knx.paramWord(StartupDelaySelection))
// Stellmotor 1 aktiviert
#define ParamDrive1Active                        ((bool)(knx.paramByte(Drive1Active) & Drive1ActiveMask))
// Stellmotor 2 aktiviert
#define ParamDrive2Active                        ((bool)(knx.paramByte(Drive2Active) & Drive2ActiveMask))
// Stellmotor 3 aktiviert
#define ParamDrive3Active                        ((bool)(knx.paramByte(Drive3Active) & Drive3ActiveMask))
// Stellmotor 4 aktiviert
#define ParamDrive4Active                        ((bool)(knx.paramByte(Drive4Active) & Drive4ActiveMask))
// Stellmotor 5 aktiviert
#define ParamDrive5Active                        ((bool)(knx.paramByte(Drive5Active) & Drive5ActiveMask))
// Stellmotor 6 aktiviert
#define ParamDrive6Active                        ((bool)(knx.paramByte(Drive6Active) & Drive6ActiveMask))
// Stellmotor 7 aktiviert
#define ParamDrive7Active                        ((bool)(knx.paramByte(Drive7Active) & Drive7ActiveMask))
// Stellmotor 8 aktiviert
#define ParamDrive8Active                        ((bool)(knx.paramByte(Drive8Active) & Drive8ActiveMask))
// Stellmotor 1 Control-Loop
#define ParamDrive1ControlLoop                   ((bool)(knx.paramByte(Drive1ControlLoop) & Drive1ControlLoopMask))
// Stellmotor 2 Control-Loop
#define ParamDrive2ControlLoop                   ((bool)(knx.paramByte(Drive2ControlLoop) & Drive2ControlLoopMask))
// Stellmotor 3 Control-Loop
#define ParamDrive3ControlLoop                   ((bool)(knx.paramByte(Drive3ControlLoop) & Drive3ControlLoopMask))
// Stellmotor 4 Control-Loop
#define ParamDrive4ControlLoop                   ((bool)(knx.paramByte(Drive4ControlLoop) & Drive4ControlLoopMask))
// Stellmotor 5 Control-Loop
#define ParamDrive5ControlLoop                   ((bool)(knx.paramByte(Drive5ControlLoop) & Drive5ControlLoopMask))
// Stellmotor 6 Control-Loop
#define ParamDrive6ControlLoop                   ((bool)(knx.paramByte(Drive6ControlLoop) & Drive6ControlLoopMask))
// Stellmotor 7 Control-Loop
#define ParamDrive7ControlLoop                   ((bool)(knx.paramByte(Drive7ControlLoop) & Drive7ControlLoopMask))
// Stellmotor 8 Control-Loop
#define ParamDrive8ControlLoop                   ((bool)(knx.paramByte(Drive8ControlLoop) & Drive8ControlLoopMask))
// Vor- und Rücklauf-Temperaturen Ausgeben
#define ParamPrePostTemperaturesOutput           ((bool)(knx.paramByte(PrePostTemperaturesOutput) & PrePostTemperaturesOutputMask))
// Temperaturen zyklisch senden (Sekunden)
#define ParamTemperatureSendIntervalSeconds      (knx.paramWord(TemperatureSendIntervalSeconds))
// Senden ab Temperaturänderung (0,01 Grad; 0 = aus)
#define ParamTemperatureChangeThresholdCenti     (knx.paramWord(TemperatureChangeThresholdCenti))

// Communication objects with single occurrence
#define KoSoll_Temperatur_1 1
#define KoSoll_Temperatur_2 2
#define KoSoll_Temperatur_3 3
#define KoSoll_Temperatur_4 4
#define KoSoll_Temperatur_5 5
#define KoSoll_Temperatur_6 6
#define KoSoll_Temperatur_7 7
#define KoSoll_Temperatur_8 8
#define KoIst_Temperatur_1 9
#define KoIst_Temperatur_2 10
#define KoIst_Temperatur_3 11
#define KoIst_Temperatur_4 12
#define KoIst_Temperatur_5 13
#define KoIst_Temperatur_6 14
#define KoIst_Temperatur_7 15
#define KoIst_Temperatur_8 16
#define KoStell_Wert_1 17
#define KoStell_Wert_2 18
#define KoStell_Wert_3 19
#define KoStell_Wert_4 20
#define KoStell_Wert_5 21
#define KoStell_Wert_6 22
#define KoStell_Wert_7 23
#define KoStell_Wert_8 24
#define KoT0 25
#define KoT1 26
#define KoT2 27
#define KoT3 28
#define KoT4 29
#define KoT5 30
#define KoT6 31
#define KoT7 32
#define KoT8 33
#define KoTemperatureBridgeOnline 34
#define KoTemperatureValidMask 35

// Die Soll-Temperatur für die Steuerung von Stellmotor 1
#define KoSoll_Temperatur_1Object                   (knx.getGroupObject(KoSoll_Temperatur_1))
// Die Soll-Temperatur für die Steuerung von Stellmotor 2
#define KoSoll_Temperatur_2Object                   (knx.getGroupObject(KoSoll_Temperatur_2))
// Die Soll-Temperatur für die Steuerung von Stellmotor 3
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
// ATtiny-Temperaturverbindung online
#define KoTemperatureBridgeOnlineObject             (knx.getGroupObject(KoTemperatureBridgeOnline))
// Gültige Temperaturkanäle T0 bis T8 (Bitmaske)
#define KoTemperatureValidMaskObject                (knx.getGroupObject(KoTemperatureValidMask))

#ifdef MAIN_FirmwareRevision
#ifndef FIRMWARE_REVISION
#define FIRMWARE_REVISION MAIN_FirmwareRevision
#endif
#endif
#ifdef MAIN_FirmwareName
#ifndef FIRMWARE_NAME
#define FIRMWARE_NAME MAIN_FirmwareName
#endif
#endif
