dayaftereh/open-knx-valve-control/(commit log)

2025-11-14 inital commit
    [sch-knx-valve-control_v1.0.json]
2025-11-17 did some work
    [pcb_knx-valve-control_v1.0.json, pcb_updi_programmer_v1.3.json, sch-knx-valve-control_v1.0.json, sch_knx-valve-control_v1.0.json, sch_updi_programmer_v1.3.json]
2025-11-18 some work done
    [pcb_knx-valve-control_v1.0.json, sch_knx-valve-control_v1.0.json]
2025-11-18 some worjk
    [pcb_knx-valve-control_v1.0.json]
2025-11-18 firxt knx valve control bord done
    [pcb_knx-valve-control_v1.0.json]
2025-11-21 added bom list
2025-12-12 added usb-broker 3d model
    [usb-broker-button.stl, usb-broker-case.FCStd, usb-broker-case.stl, usb-broker-lid.stl]
2025-12-12 worked on spi slave
2025-12-15 started with spi com
2025-12-15 try to start with spi
2025-12-16 got working spi
2025-12-16 fixed issue with spi
    [sch_knx-valve-control_v1.1.json]
2025-12-17 fixed spi on pcb
    [pcb_knx-valve-control_v1.1.json, sch_knx-valve-control_v1.1.json]
2025-12-19 try to fix issue with temp index
    [main.cpp, spi-slave.cpp, spi-slave.hpp, temperatures.cpp, temperatures.hpp]
2025-12-21 fixed tempertures and started with drives
    [config.hpp, error.hpp, main.cpp, spi-slave.cpp, spi-slave.hpp, temperatures.cpp, temperatures.hpp]
2026-01-13 added rp2040
    [pcb_knx-valve-control_v1.2.json]
2026-01-14 started with rp2040 version
    [pcb_knx-valve-control_v1.2.json, sch_knx-valve-control_v1.2.json]
2026-01-14 worked on rp2040
    [pcb_knx-valve-control_v1.2.json]
2026-01-15 some changes
    [pcb_knx-valve-control_v1.2.json]
2026-01-16 added new rp2040 version
    [pcb_knx-valve-control_v1.2.json]
2026-01-21 added knx-value-control din-rail mount
    [knx-valve-control-din-rail-mount.FCStd, knx-valve-control-din-rail-mount.stl]
2026-01-21 opt din rail mount
    [knx-valve-control-din-rail-mount.FCStd, knx-valve-control-din-rail-mount.stl]
2026-02-02 worked on knx integration
    [pcb_knx-valve-control_v1.0.json, pcb_knx-valve-control_v1.1.json, pcb_updi_programmer_v1.3.json, sch_knx-valve-control_v1.0.json, sch_knx-valve-control_v1.1.json, sch_updi_programmer_v1.3.json]
2026-10-09 docs: document HmIP-VDMOT actuator and KNX ETS concept
2026-10-09 docs: audit KNX valve controller schematic v1.2
2026-10-09 docs: audit PCB V1.2 and ETS product generation
2026-10-09 docs: plan external 5V KNX valve power and jumper safety
2026-10-10 docs(ash): KNX012 plan software-first temperature and UART bridge
2026-10-10 feat(knx013): add asynchronous ATtiny nine-sensor sampler
2026-10-11 docs(ash): close KNX013 after sampler QA
2026-10-11 feat(knx014): add CRC framed UART temperature bridge
2026-10-11 docs(ash): close KNX014 UART software gate
2026-10-12 feat(knx015): publish ETS-configurable KNX temperature telemetry
2026-10-12 feat(knx020): simulate exclusive eight-motor motion queue
2026-10-12 docs(ash): close KNX020 exclusive motor queue simulation
2026-10-12 test(knx021): integrate room PI zones and exclusive virtual motor feedback
2026-10-12 docs(ash): close KNX021 end-to-end virtual motor feedback gate
2026-10-12 docs(knx022): audit V1.2 hardware blockers against schematic PCB and firmware
2026-10-13 build(knx028): pin reproducible RP2040 toolchain and pass Home native QA
2026-10-13 feat(knx030): add passive LLO Home device baseline and first-contact diff
2026-10-13 feat(knx031): add offline UART trace decoder and C++ golden vectors
2026-10-13 docs(ash): close KNX031 offline UART trace diagnostics
2026-10-13 test(knx032): replay KNX014 UART through actual KNX015 publisher offline
2026-10-13 docs(ash): close KNX032 UART-to-KNX native replay QA
2026-10-14 docs(knx035): flag STKNX TX idle-high pullup and UART PHY hazard
2026-10-14 feat(knx038): prepare ATtiny3216 UPDI RTS and voltage-gated signature check
2026-10-14 docs(ash): close KNX038 UPDI RTS voltage preflight
2026-10-14 feat(knx040): flash ATtiny and validate real nine-channel UART no-sensor protocol
2026-10-14 docs(ash): close KNX040 real temperature UART first-contact tests
2026-10-14 fix(knx041): correct temperature UART boolean write readiness
2026-10-14 feat(knx042): prepare isolated USB-only motor LED pulse diagnostic
2026-10-14 feat(knx042): flash isolated M1 LED diagnostic and record first live hold
2026-10-14 test(knx042): record repeat live M1 LED hold confirmation
2026-10-14 docs(knx042): map OPEN LED to IN1 and record physical observation
2026-10-14 test(knx042): repeat M1 LED after indicator rework
2026-10-14 test(knx042): qualify bounded M1 CLOSE LED pulse train
2026-10-14 test(knx042): verify bounded M2 OPEN LED pulse train
2026-10-14 feat(knx042): prepare guarded 8-channel LED sequence and rollback UF2
2026-10-15 test(knx043): record PicoScope GND zero reference and TX delta
2026-10-15 test(knx043): confirm USB TX near GND after probe return
2026-10-17 feat(knx070): decode TP1 RX frames and cross-check KNX/IP
2026-10-18 docs(knx082): hand over TP1/IP success and staged motor-sensor bench
2026-10-18 test(knx084): verify passive KNX RX and four ATtiny sensors on live bus
2026-10-19 test(knx085): prepare INA219 current trace for isolated M1 dry-bench test
2026-10-19 test(knx085): package one-shot M1 USB bench launcher and current logs
2026-10-19 diag(knx088): audit INA219 motor-rail current and PCB load nets
2026-10-19 diag(knx090): identify 10k BOM mapping on INA sense resistors
2026-10-20 test(knx092): validate INA219 repair and first M1 USB current trace
2026-10-20 test(knx093): execute guarded 800ms M1 reverse trace on office USB bench
2026-10-20 test(knx094): capture guarded ten-second M1 reverse current trace
2026-10-20 feat(knx095): detect INA motor-load rise in first bounded homing seek
2026-10-20 test(knx096): capture complete M1 F stroke to opposite current endstop
2026-10-20 docs(knx098): accept M1 bench calibration and replay six INA traces
2026-10-20 feat(knx099): add fail-closed directional valve position model and native replay
2026-10-20 test(knx103): validate live USB M1 positional sequence and INA traces
2026-10-20 feat(knx104): add safe ETS V3 motor scaling contract and offline tests
